ese5160/a14g-final-submission-s25-t18-dualcore/(commit log)

2025-05-03 The standalone PCBA, TOP & BOTTOM
2025-05-03 Thermal Camera Image: 120% (936mA)
2025-05-03 The Altium Board Design in 2D/3D View
